sbelectronics/4004/README.md

# Scott's 4004 and 4040 Projects Repository

https://www.smbaker.com/

This repo contains various 4004 and 4040 projects.

* 4004-smbaker ... Scott's single-board 4004 / 4040 computer
