sbelectronics/4004/4004-smbaker/schematic-v0.23.pdf

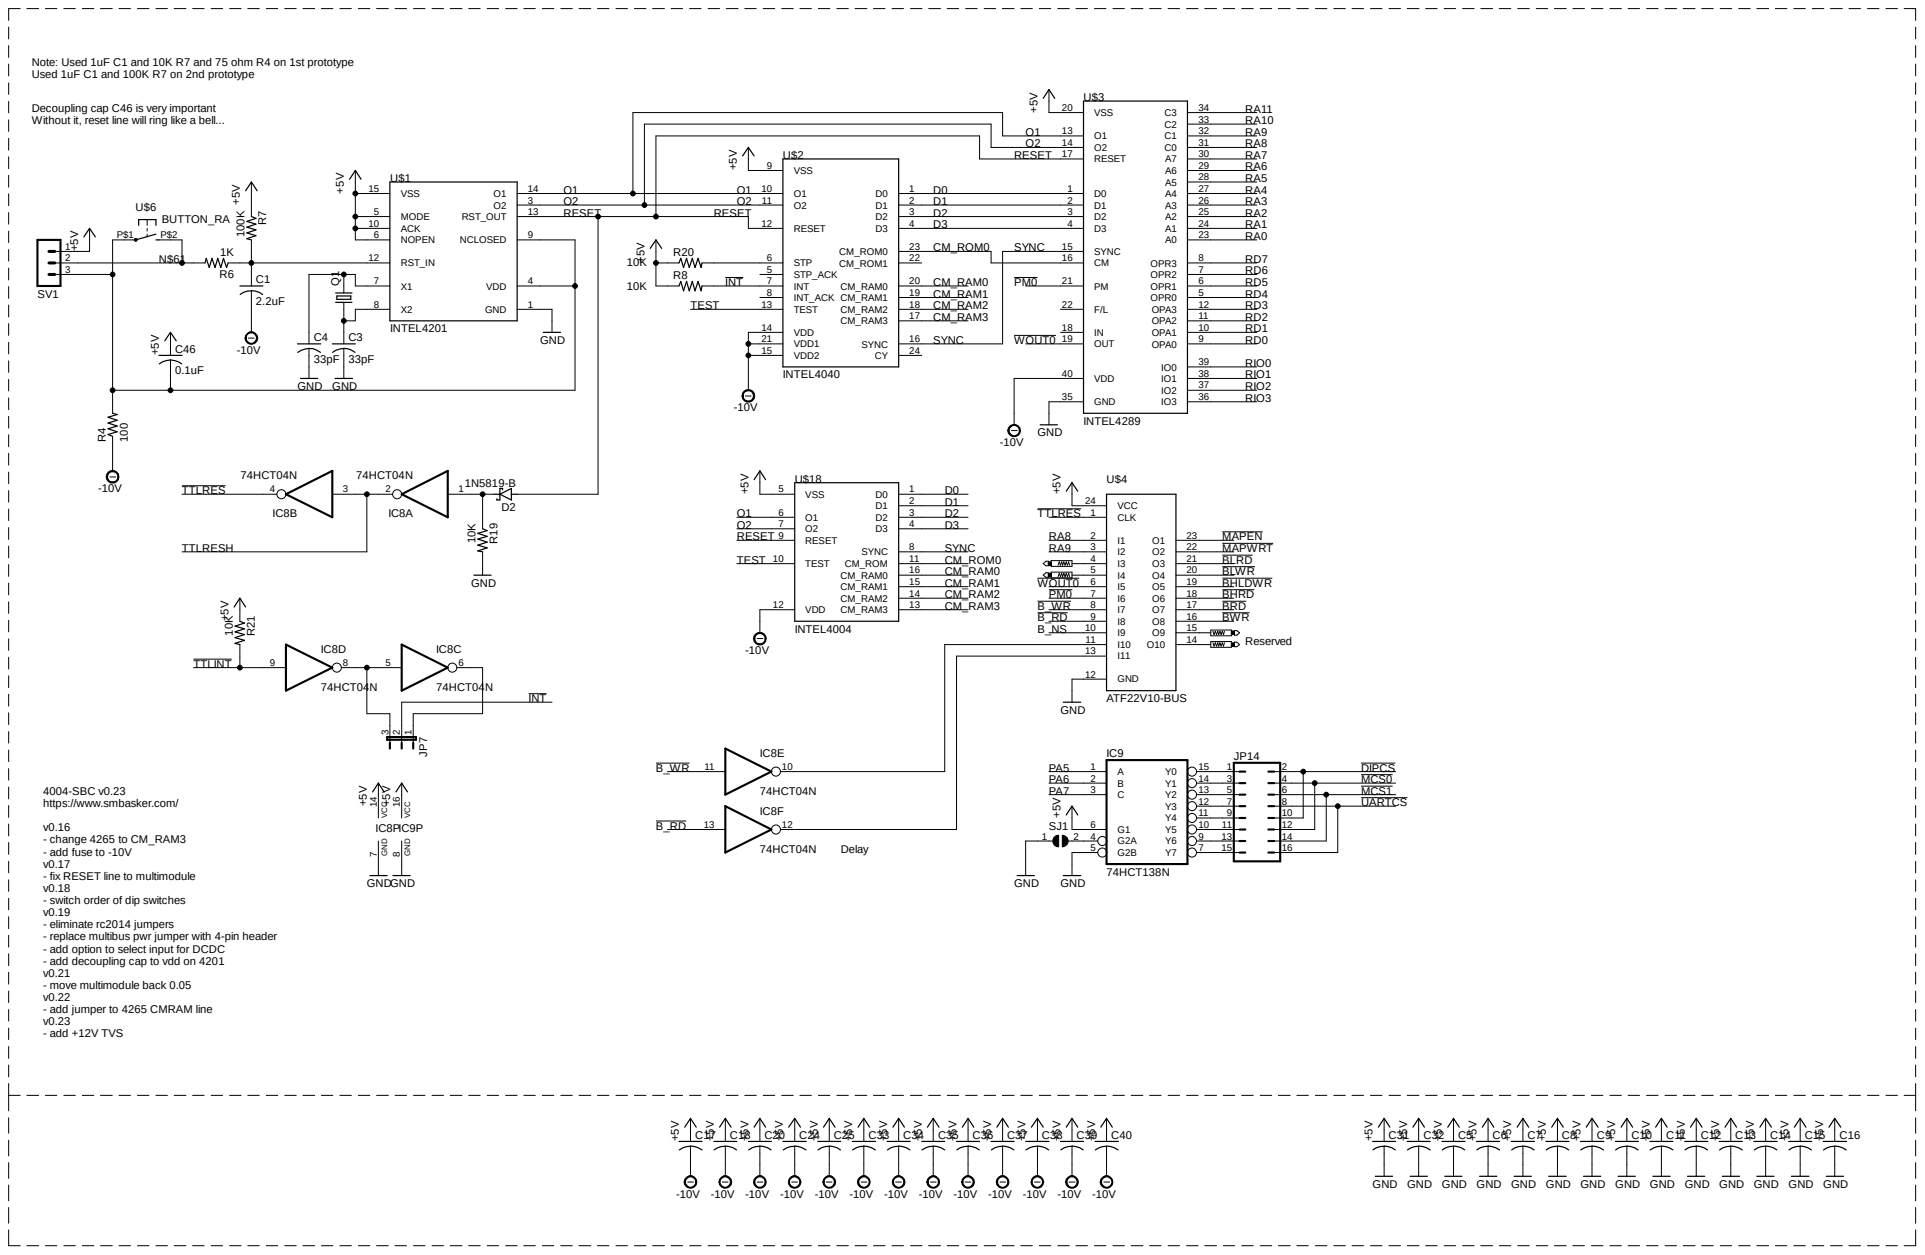
[picture p1: page 1]

Note: Used 1uF C1 and 10K R7 and 75 ohm R4 on 1st prototype
Used 1uF C1 and 100K R7 on 2nd prototype

Decoupling cap C46 is very important
Without it, reset line will ring like a bell...

INT 7 INT_ACK 8 | PM0

4004-SBC v0.23
https://www.smbasker.com/

- change 4265 to CM_RAM3
- add fuse to -10V
- fix RESET line to multimodule
- switch order of dip switches
- eliminate rc2014 jumpers
- replace multibus pwr jumper with 4-pin header
- add option to select input for DCDC
- add decoupling cap to vdd on 4201
- move multimodule back 0.05
- add jumper to 4265 CMRAM line
- add +12V TVS

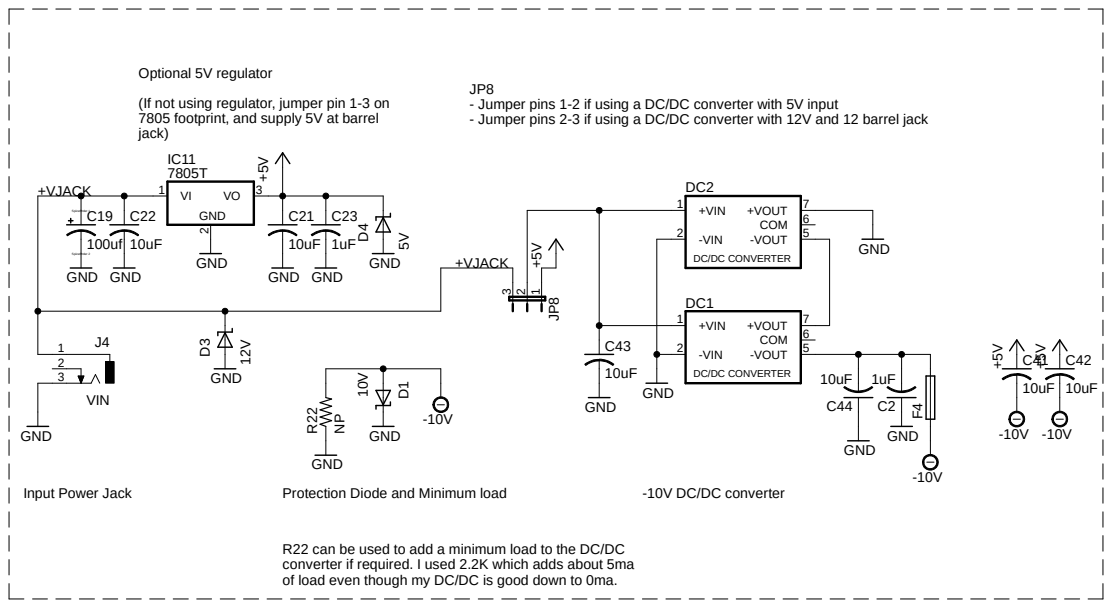
[picture p2: page 2]

- Jumper pins 1-2 if using a DC/DC converter with 5V input
- Jumper pins 2-3 if using a DC/DC converter with 12V and 12 barrel jack

(If not using regulator, jumper pin 1-3 on
7805 footprint, and supply 5V at barrel
jack)

R22 can be used to add a minimum load to the DC/DC
converter if required. I used 2.2K which adds about 5ma
of load even though my DC/DC is good down to 0ma.

U$21

See webpage for instructions.

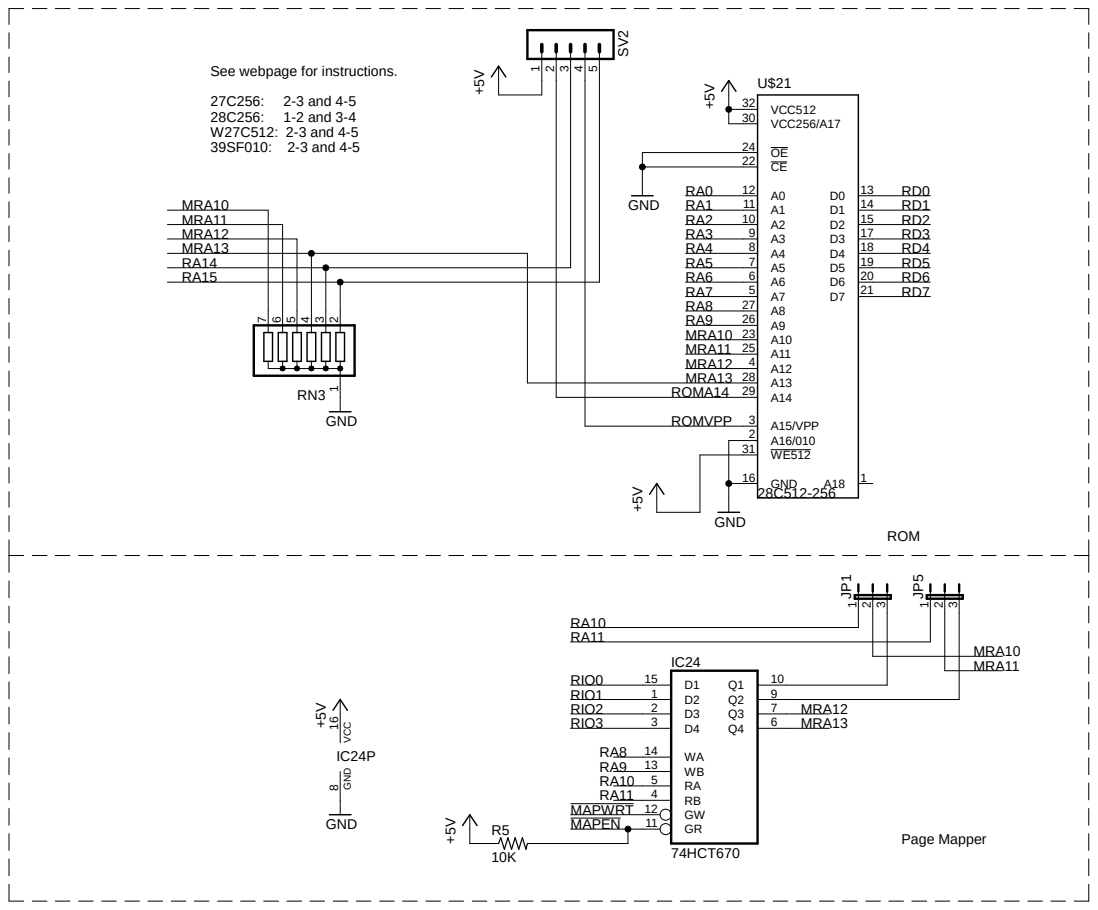
[picture p3: page 3]

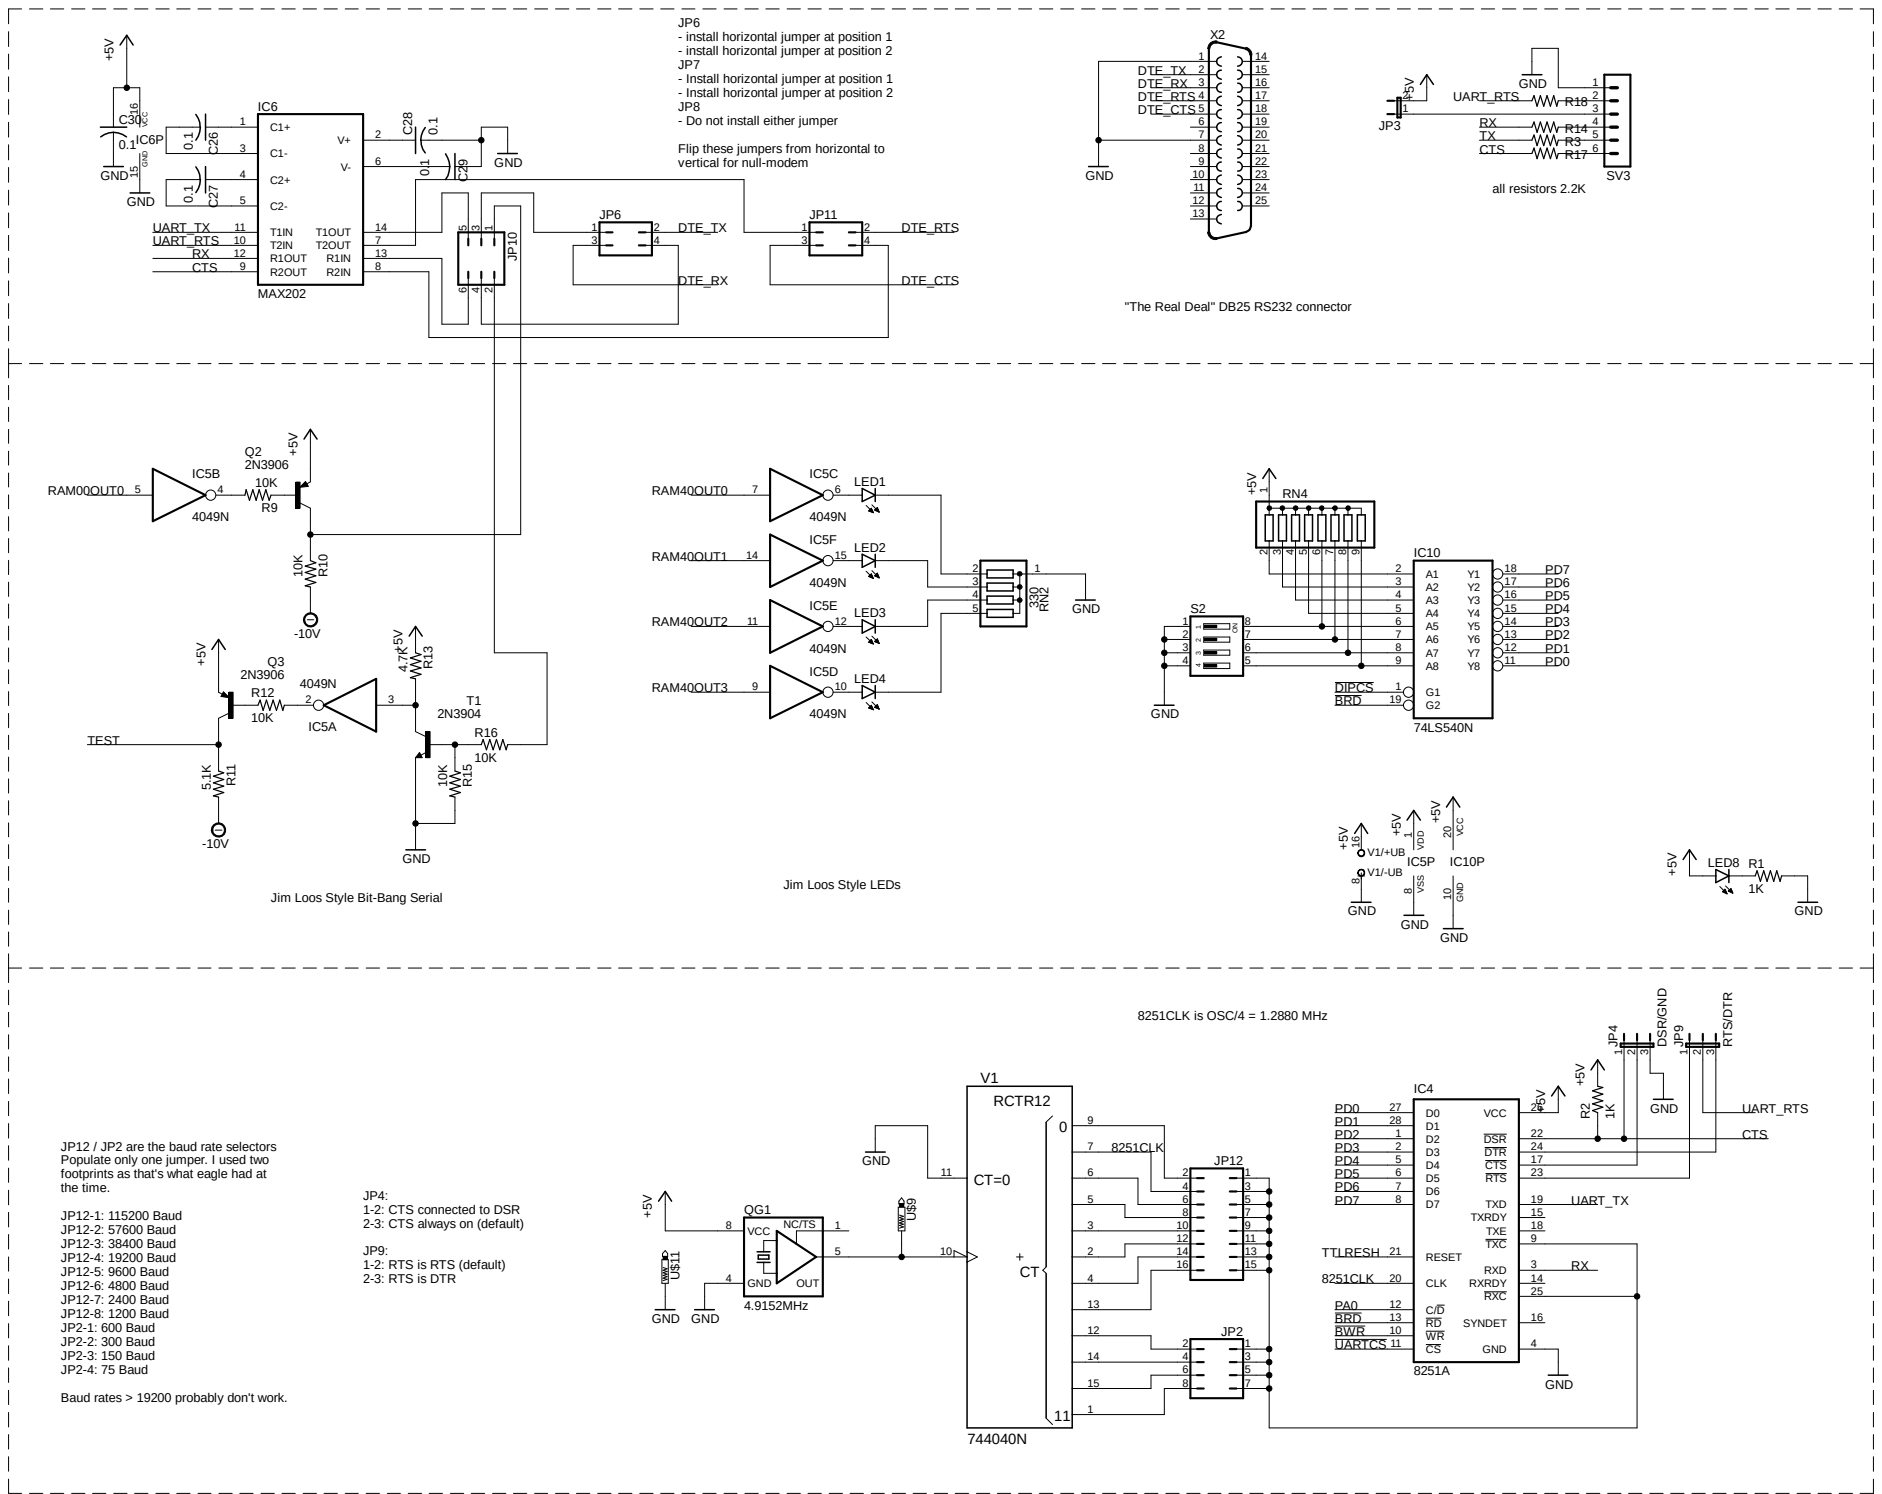
[picture p4: page 4]

- install horizontal jumper at position 1
- install horizontal jumper at position 2
- Install horizontal jumper at position 1
- Install horizontal jumper at position 2
- Do not install either jumper

Flip these jumpers from horizontal to
vertical for null-modem

"The Real Deal" DB25 RS232 connector

A4 5
A5 6

2 | 7 | | A6 7
3 | 6 | | A7 8

Jim Loos Style LEDs

Jim Loos Style Bit-Bang Serial

JP12 / JP2 are the baud rate selectors
Populate only one jumper. I used two
footprints as that's what eagle had at
the time.

1-2: CTS connected to DSR
2-3: CTS always on (default)

1-2: RTS is RTS (default)
2-3: RTS is DTR

13 | JP2 | PA0 | C/D 12
12 | | BRD | RD 13

Baud rates > 19200 probably don't work.

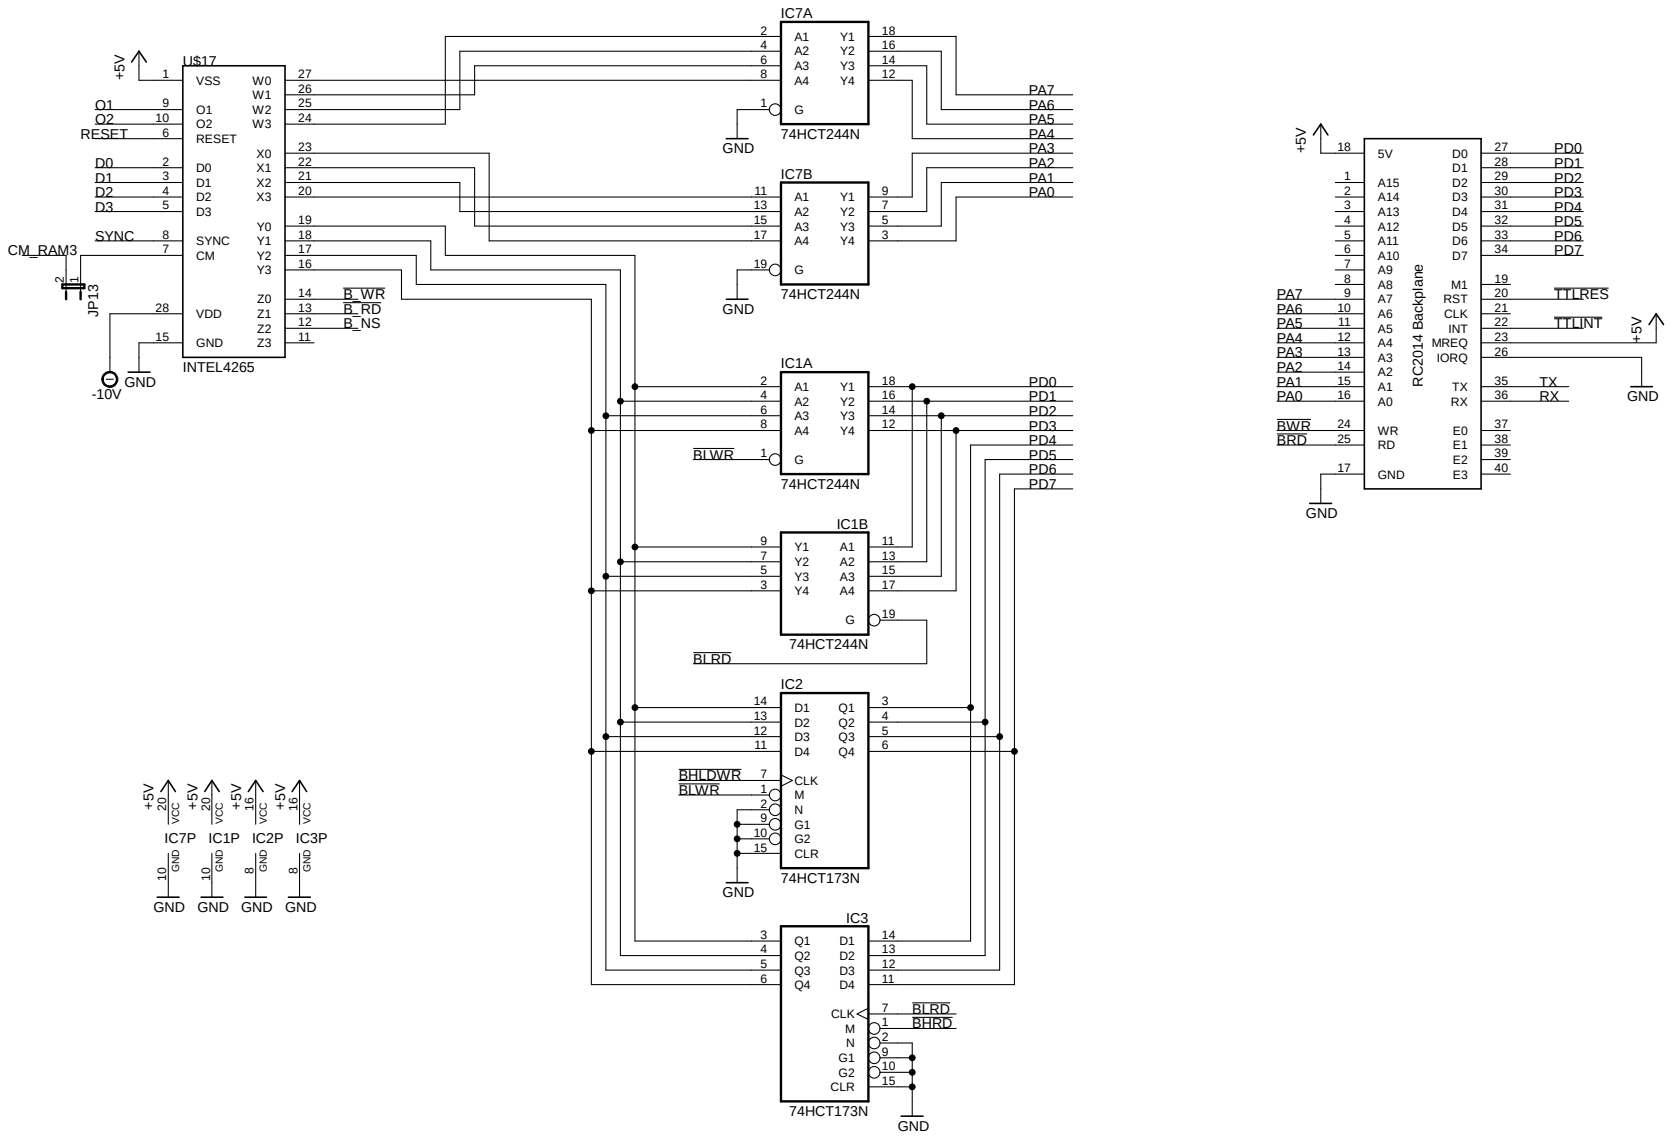
[picture p5: page 5]

A2 13 | 7 Y1
A3 15 | 5 Y2

7 1 2 | G2 10 CLR 15

GND GND

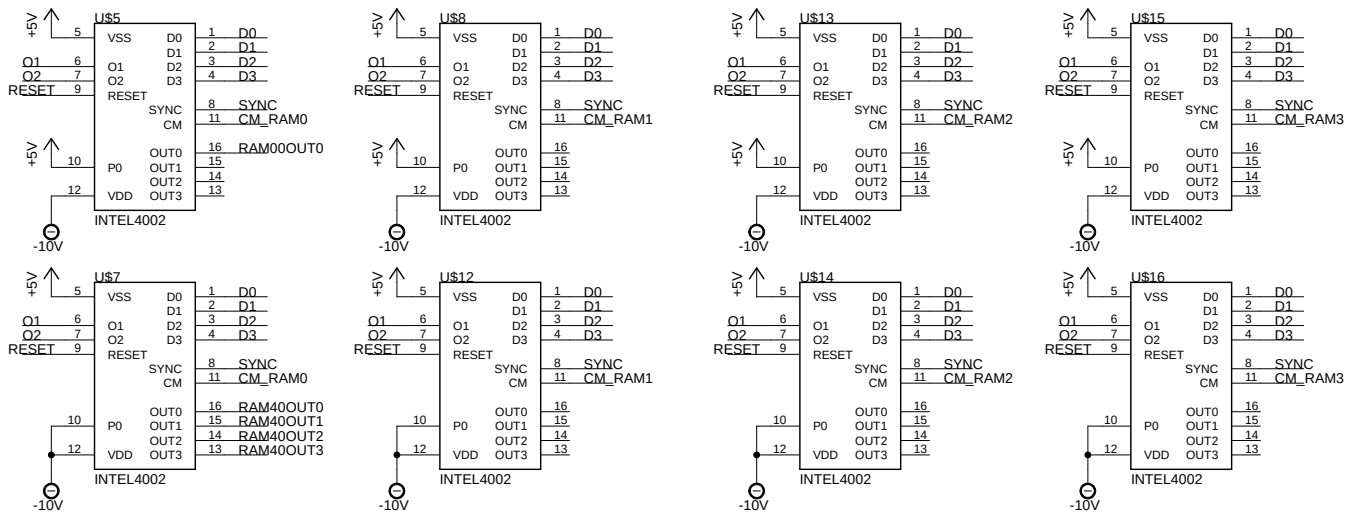
[picture p6: page 6]
VSS; RESET; VDD 12; SYNC; OUT0; OUT1; OUT2; OUT3; CM_RAM0; CM_RAM1; CM_RAM2; CM_RAM3; RAM40OUT0 RAM40OUT1 RAM40OUT2 RAM40OUT3; RAM00OUT0; INTEL4002

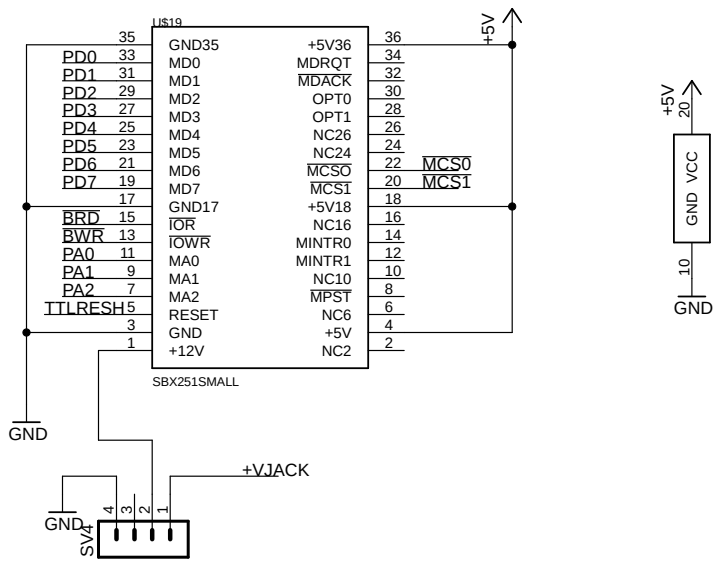
[picture p7: figure]
GND; 1 GND; RESET; 6 MPST; VCC; 20 GND; BRD BWR PA0 PA1 PA2; MCS0 MCS1; +VJACK; TTLRESH; SBX251SMALL

9 | MA0 11 | IOWR 13 | IOR 15 | GND17 17 | MD7 19 | MD6 21 | MD5 23 | MD4 25 | MD3 27 | MD2 29 | MD1 31 | MD0 33 | GND35 35
8 NC10 | 10 MINTR1 | 12 MINTR0 | 14 NC16 | 16 +5V18 | 18 MCS1 | 20 MCSO | 22 NC24 | 24 NC26 | 26 OPT1 | 28 OPT0 | 30 MDACK | 32 MDRQT | 34 +5V36 | 36
