sbelectronics/4004/(commit log)

2025-09-06 update notes on power usage
2025-09-06 update README on power requirements
2025-09-06 update key constants for second version board
2025-09-09 schematics and gerbers
    [4004-sbc.GBL, 4004-sbc.GBO, 4004-sbc.GBS, 4004-sbc.GKO, 4004-sbc.GTL, 4004-sbc.GTO, 4004-sbc.GTS, 4004-sbc.XLN]
